AlexanderVerl/Table-Musicale/Infrorouge/5.8.jpg

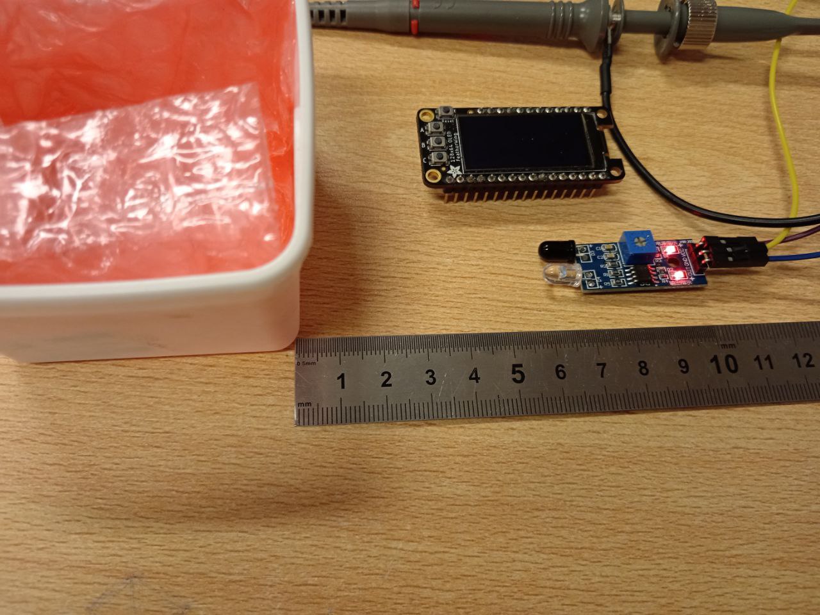
Infrorouge/5.8.jpg
