AlexanderVerl/Table-Musicale/Infrorouge/5.5cm.jpg

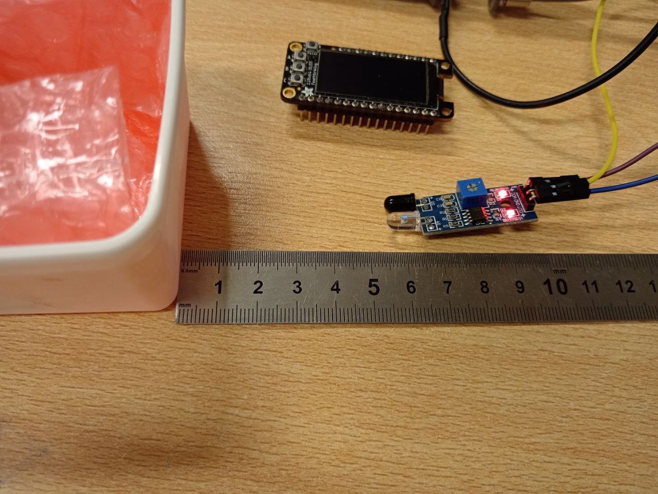
Infrorouge/5.5cm.jpg
