AlexanderVerl/Table-Musicale/Infrorouge/Capteur IR.docx

Ir c’est quoi ?

L’infrarouge est un

IR Sensor Module Parts

Expliquer le schéma

IR Sensor Module Circuit Diagram

On utilise AOP dans le circuit HW-201.

Sources : https://circuitdigest.com/microcontroller-projects/interfacing-ir-sensor-module-with-arduino
