AlexanderVerl/Table-Musicale/Infrorouge/5.5cm.PNG

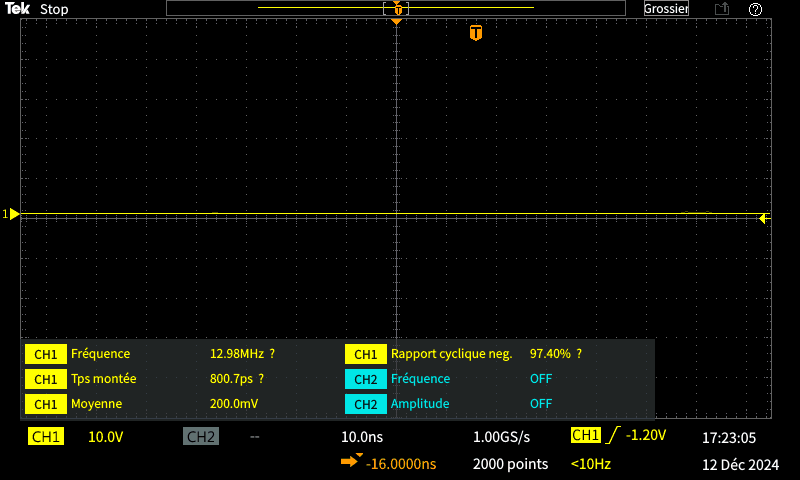
Infrorouge/5.5cm.PNG
