AlexanderVerl/Table-Musicale/Neopixel/0.5T.PNG

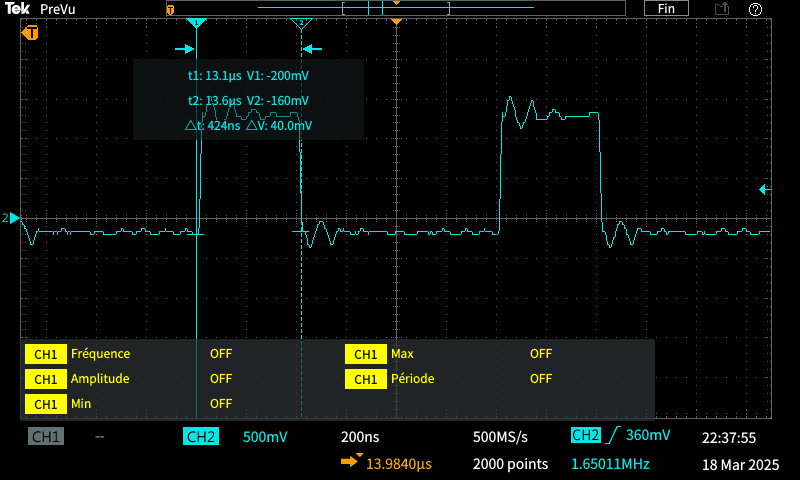
Neopixel/0.5T.PNG
