AlexanderVerl/Table-Musicale/Neopixel/0T.PNG

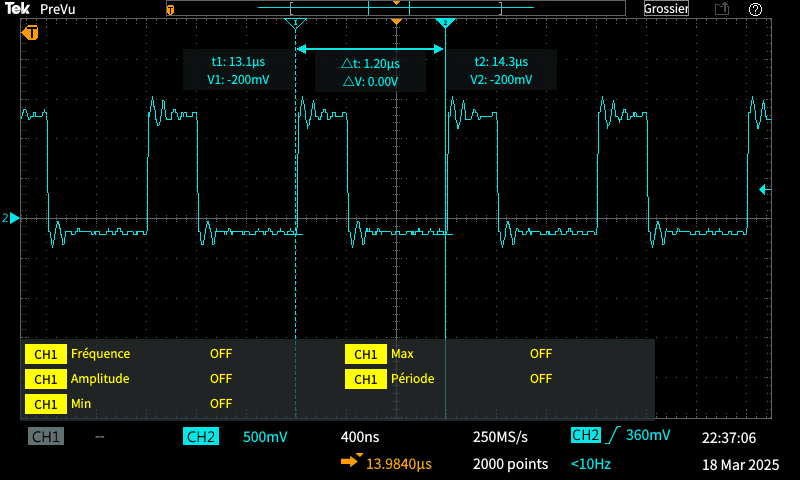
Neopixel/0T.PNG
