AlexanderVerl/Table-Musicale/Neopixel/1.5T.PNG

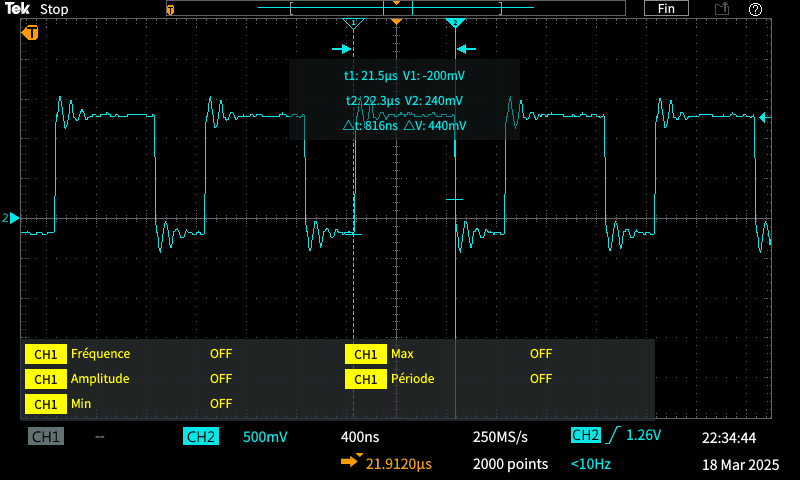
Neopixel/1.5T.PNG
