AlexanderVerl/Table-Musicale/Neopixel/All bus.PNG

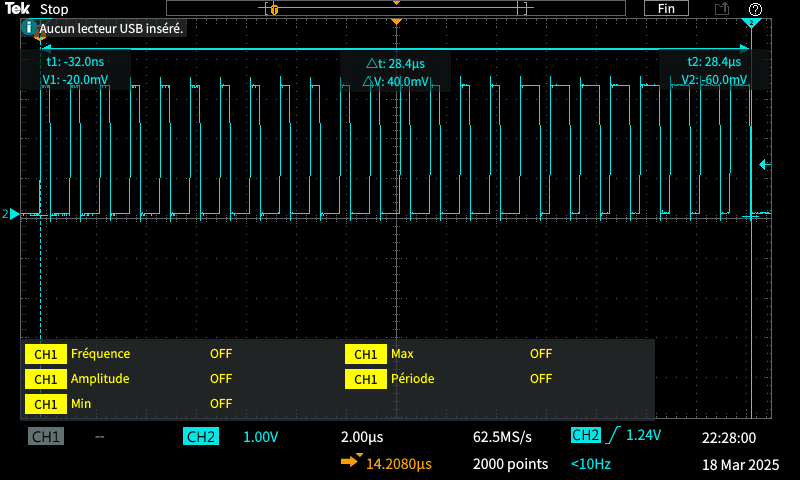
Neopixel/All bus.PNG
