AlexanderVerl/Table-Musicale/Neopixel/T1.PNG

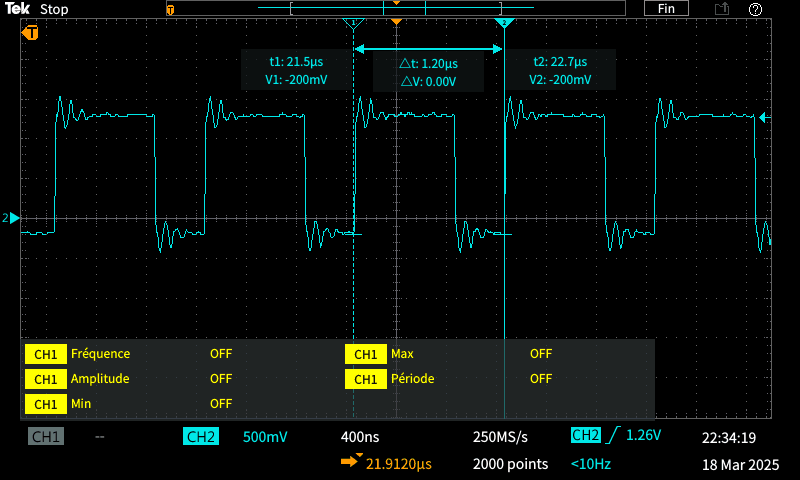
Neopixel/T1.PNG
