AlexanderVerl/Table-Musicale/(commit log)

2025-04-03 test de mis à jour
    le teste pour mis a jour et voir comment ca fonction
2025-04-15 I²C et I2S
    Il y a un conflict entre les 2 bus
2025-05-22 Ajoutation des messures
    J'ajoute de mesures qui ont été oublié d'etre ajouté
2025-06-09 generator des notes
